electrickery/ps2keyboard2matrix/AsterCT-80_keyboard.png

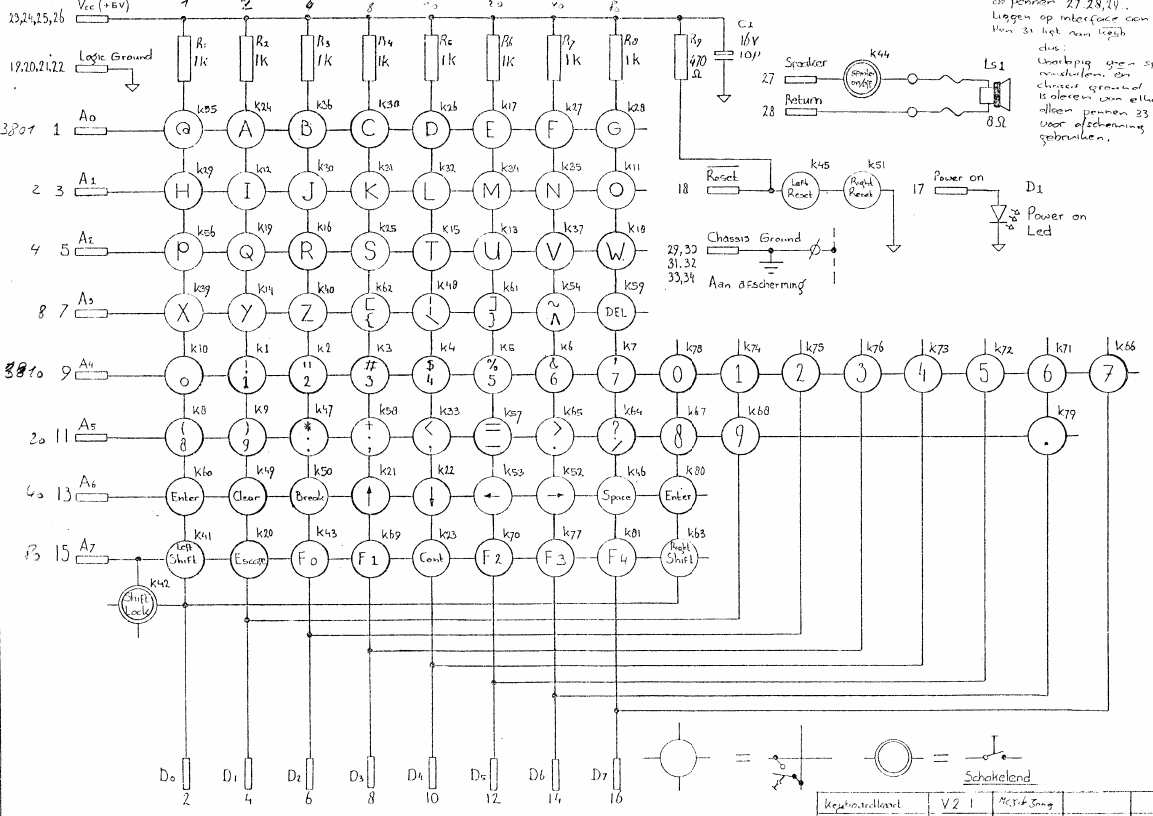
AsterCT-80_keyboard.png
