electrickery/ps2keyboard2matrix/ps2-ct80-keyboardConverter1.0.jpg

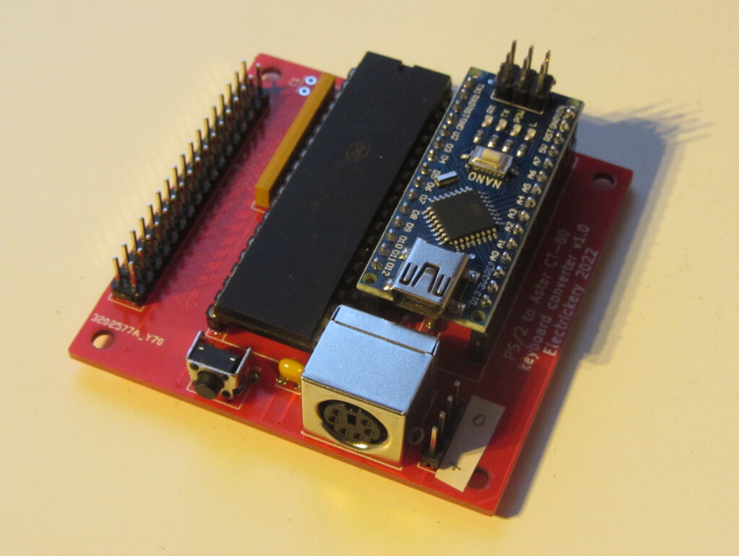
ps2-ct80-keyboardConverter1.0.jpg
