electrickery/ps2keyboard2matrix/keyboardEmuMT.V1.2.kicad_sch.pdf

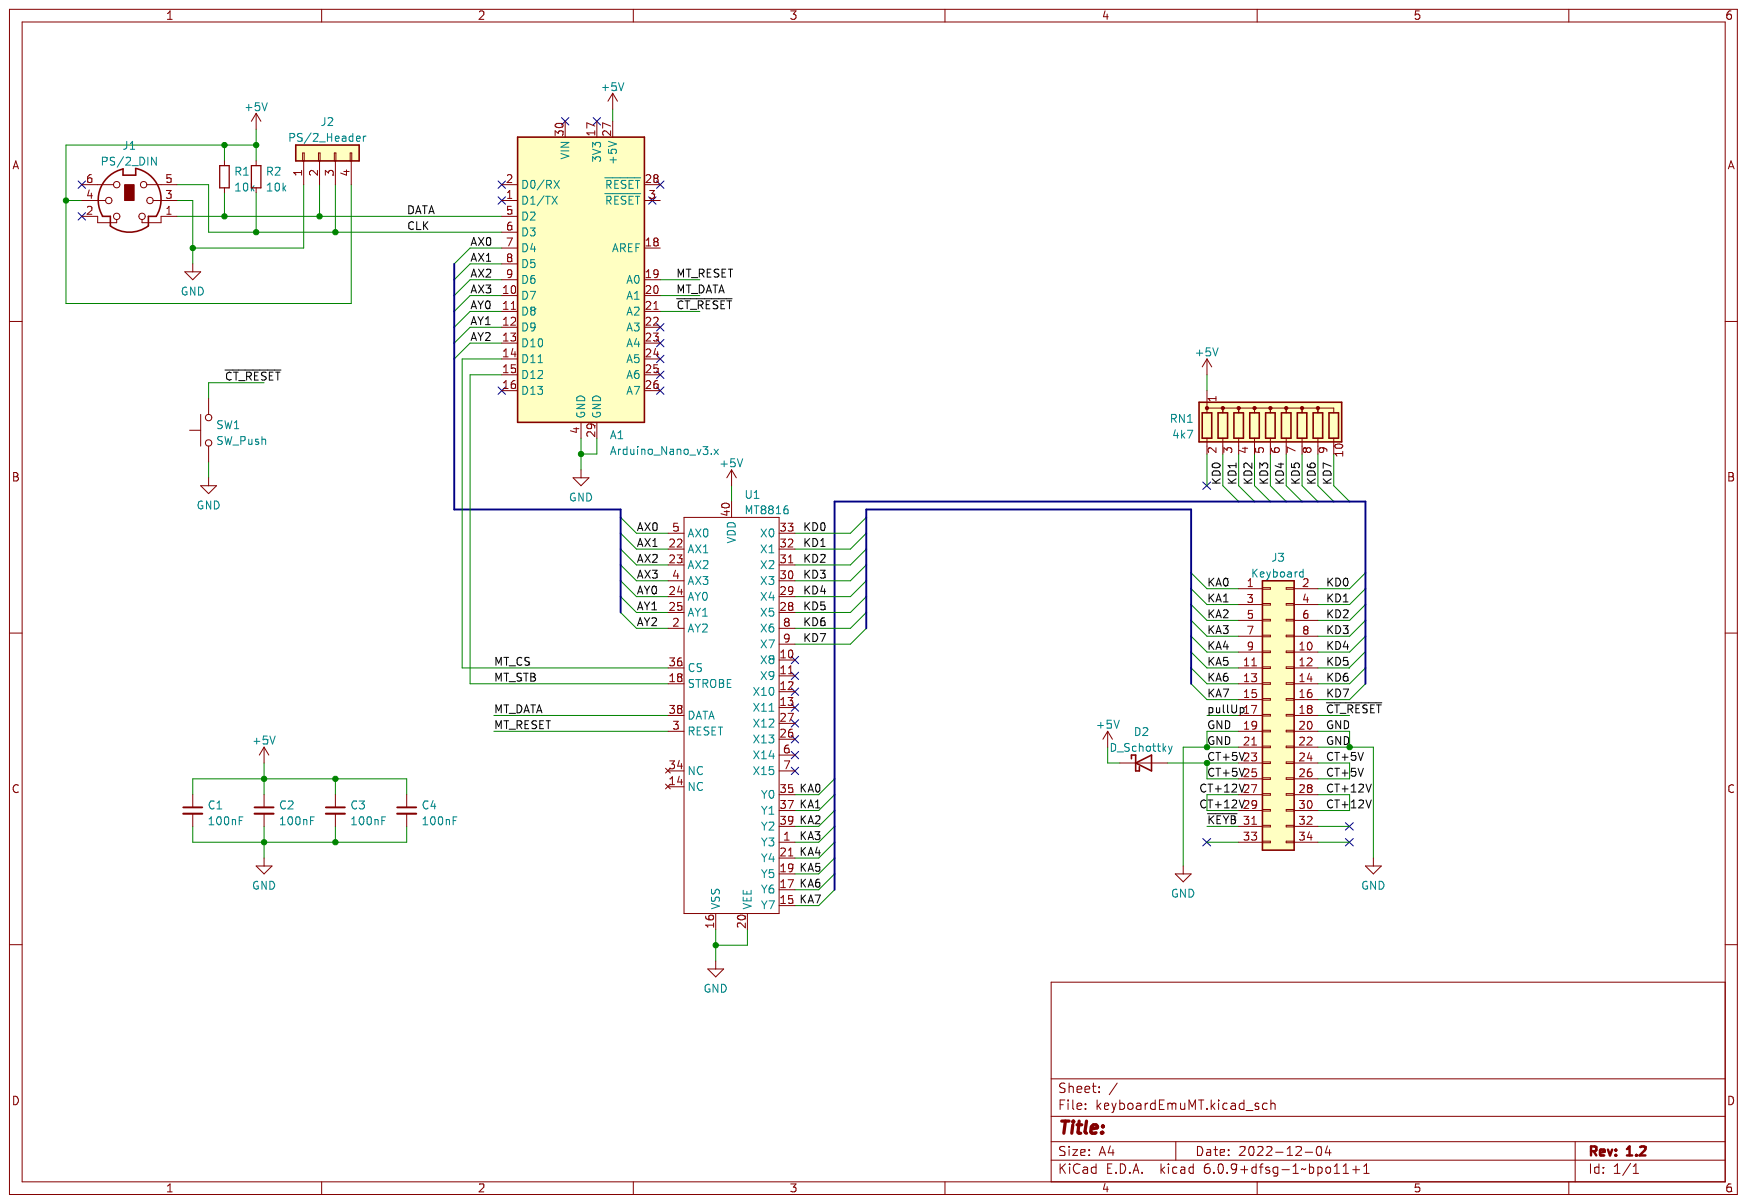
[picture p4: page 1]
