electrickery/ps2keyboard2matrix/keyboardEmuMT.V1.1.kicad_sch.pdf

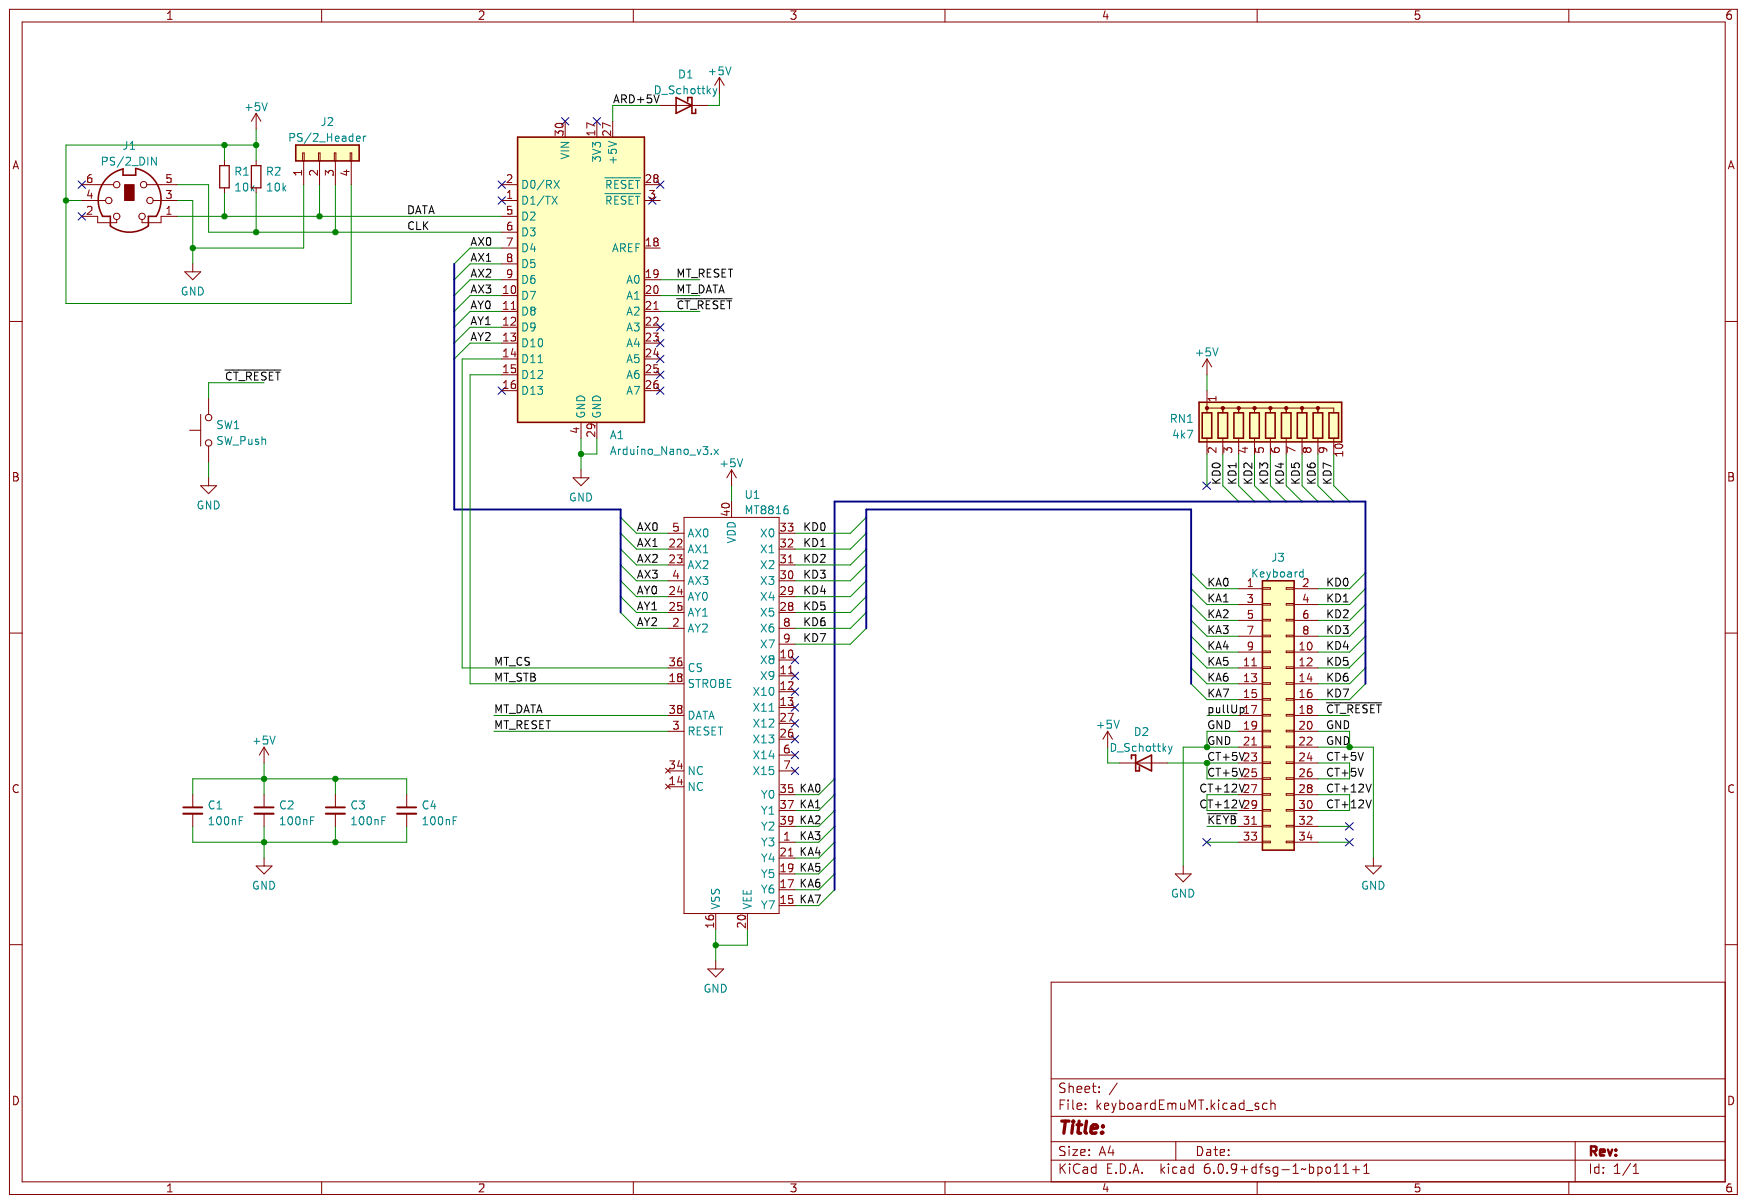
[picture p5: page 1]
