electrickery/ps2keyboard2matrix/(commit log)

2022-11-12 PDF schema of the new board.
2022-11-29 Reorganized directory to work with both git and Arduino-IDE. Tabelized the plain special keys.
2022-11-29 New PCB image and code cleanup.
2022-12-01 Arduino & library versions.
2022-12-04 Updated schematic to final version 1.2.
2023-01-01 Added KiCAD files, both prject as production files.
2023-01-01 Added KiCAD project files files, including interactive BOM.html.
2023-01-12 Fixed faulty ':' MXCOLON and added example keyboard matrix.
    [ascii2trs80m1keymap.h, ps2KeyboardAsciiInterpreterMT.ino]
